freedom8623/Capacitance_meter/(list of files, drawings)

Other design files:
硬件原理图以及PCB/数字电容表（嘉立创专业版）.epro
